free-artp/talker_hardware/README.md

Eagle project about ATMEGA168 for wood's sort device (p-dok.ru)

Print out:
	Bottom
	Pad
	Via
	Dimension
	Holes

Mirror + Pos.coord

Offcet:
X = 2.2 inch
Y = 7 inch

Hot iron - 40 sec, full power, by my hand not a body
11:38
