free-artp/talker_hardware/sortirovka/README.txt

top_metal.gbr		- Медь, верхний слой.
top_metal.gpi		- Информация о формате файла верхнего слоя меди
bottom_metal.gbr	- Медь, нижний слой.
bottom_metal.gpi	- Информация о формате файла нижнего слоя меди.
top_mask.gbr		- Паяльная маска (Solder Stop), верхний слой.
top_mask.gpi		- Инфо о формате файла паяльной маски верхнего слоя.
bottom_mask.gbr		- Паяльная маска (Solder stop), нижнй слой.
bottom_mask.gpi		- Инфо о формате файла паяльной маски нижнего слоя
brd.gbr			- Слой габаритных размеров платы
brd.gpi			- Информация о формате файла габаритных размеров
drill.dri		- Файл сверловки, формат EXCELON
drill.txt		- Информация о формате файла сверловки
top_silk.gbr		- Шелкография, верхний слой.
top_silk.gpi		- Информация о формате файла шелкографии.
