free-artp/talker_hardware/pcb.png

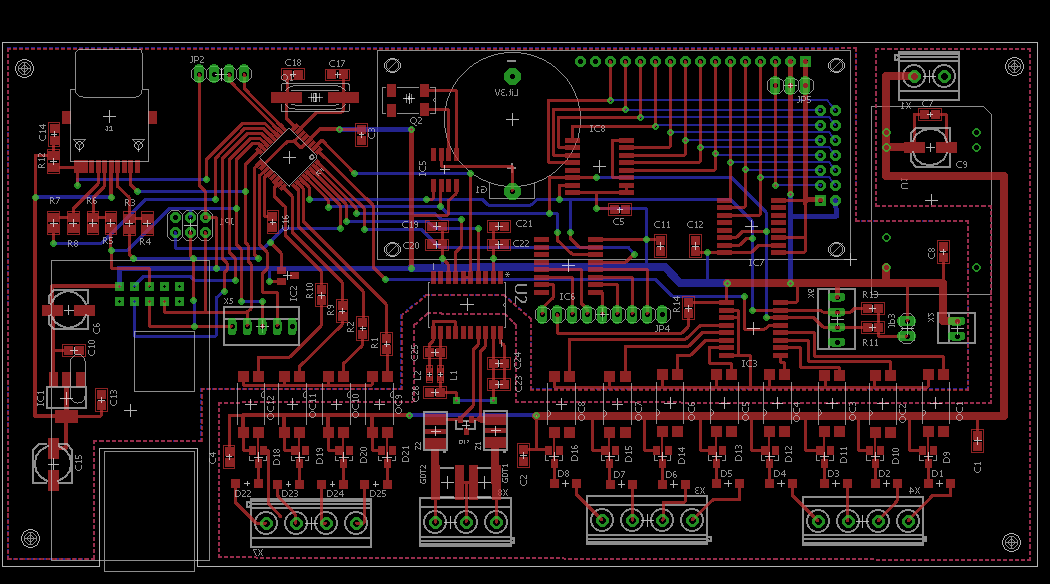
pcb.png
