free-artp/talker_hardware/sortirovka.brd

## EAGLE design sortirovka.brd (2017-11-27)

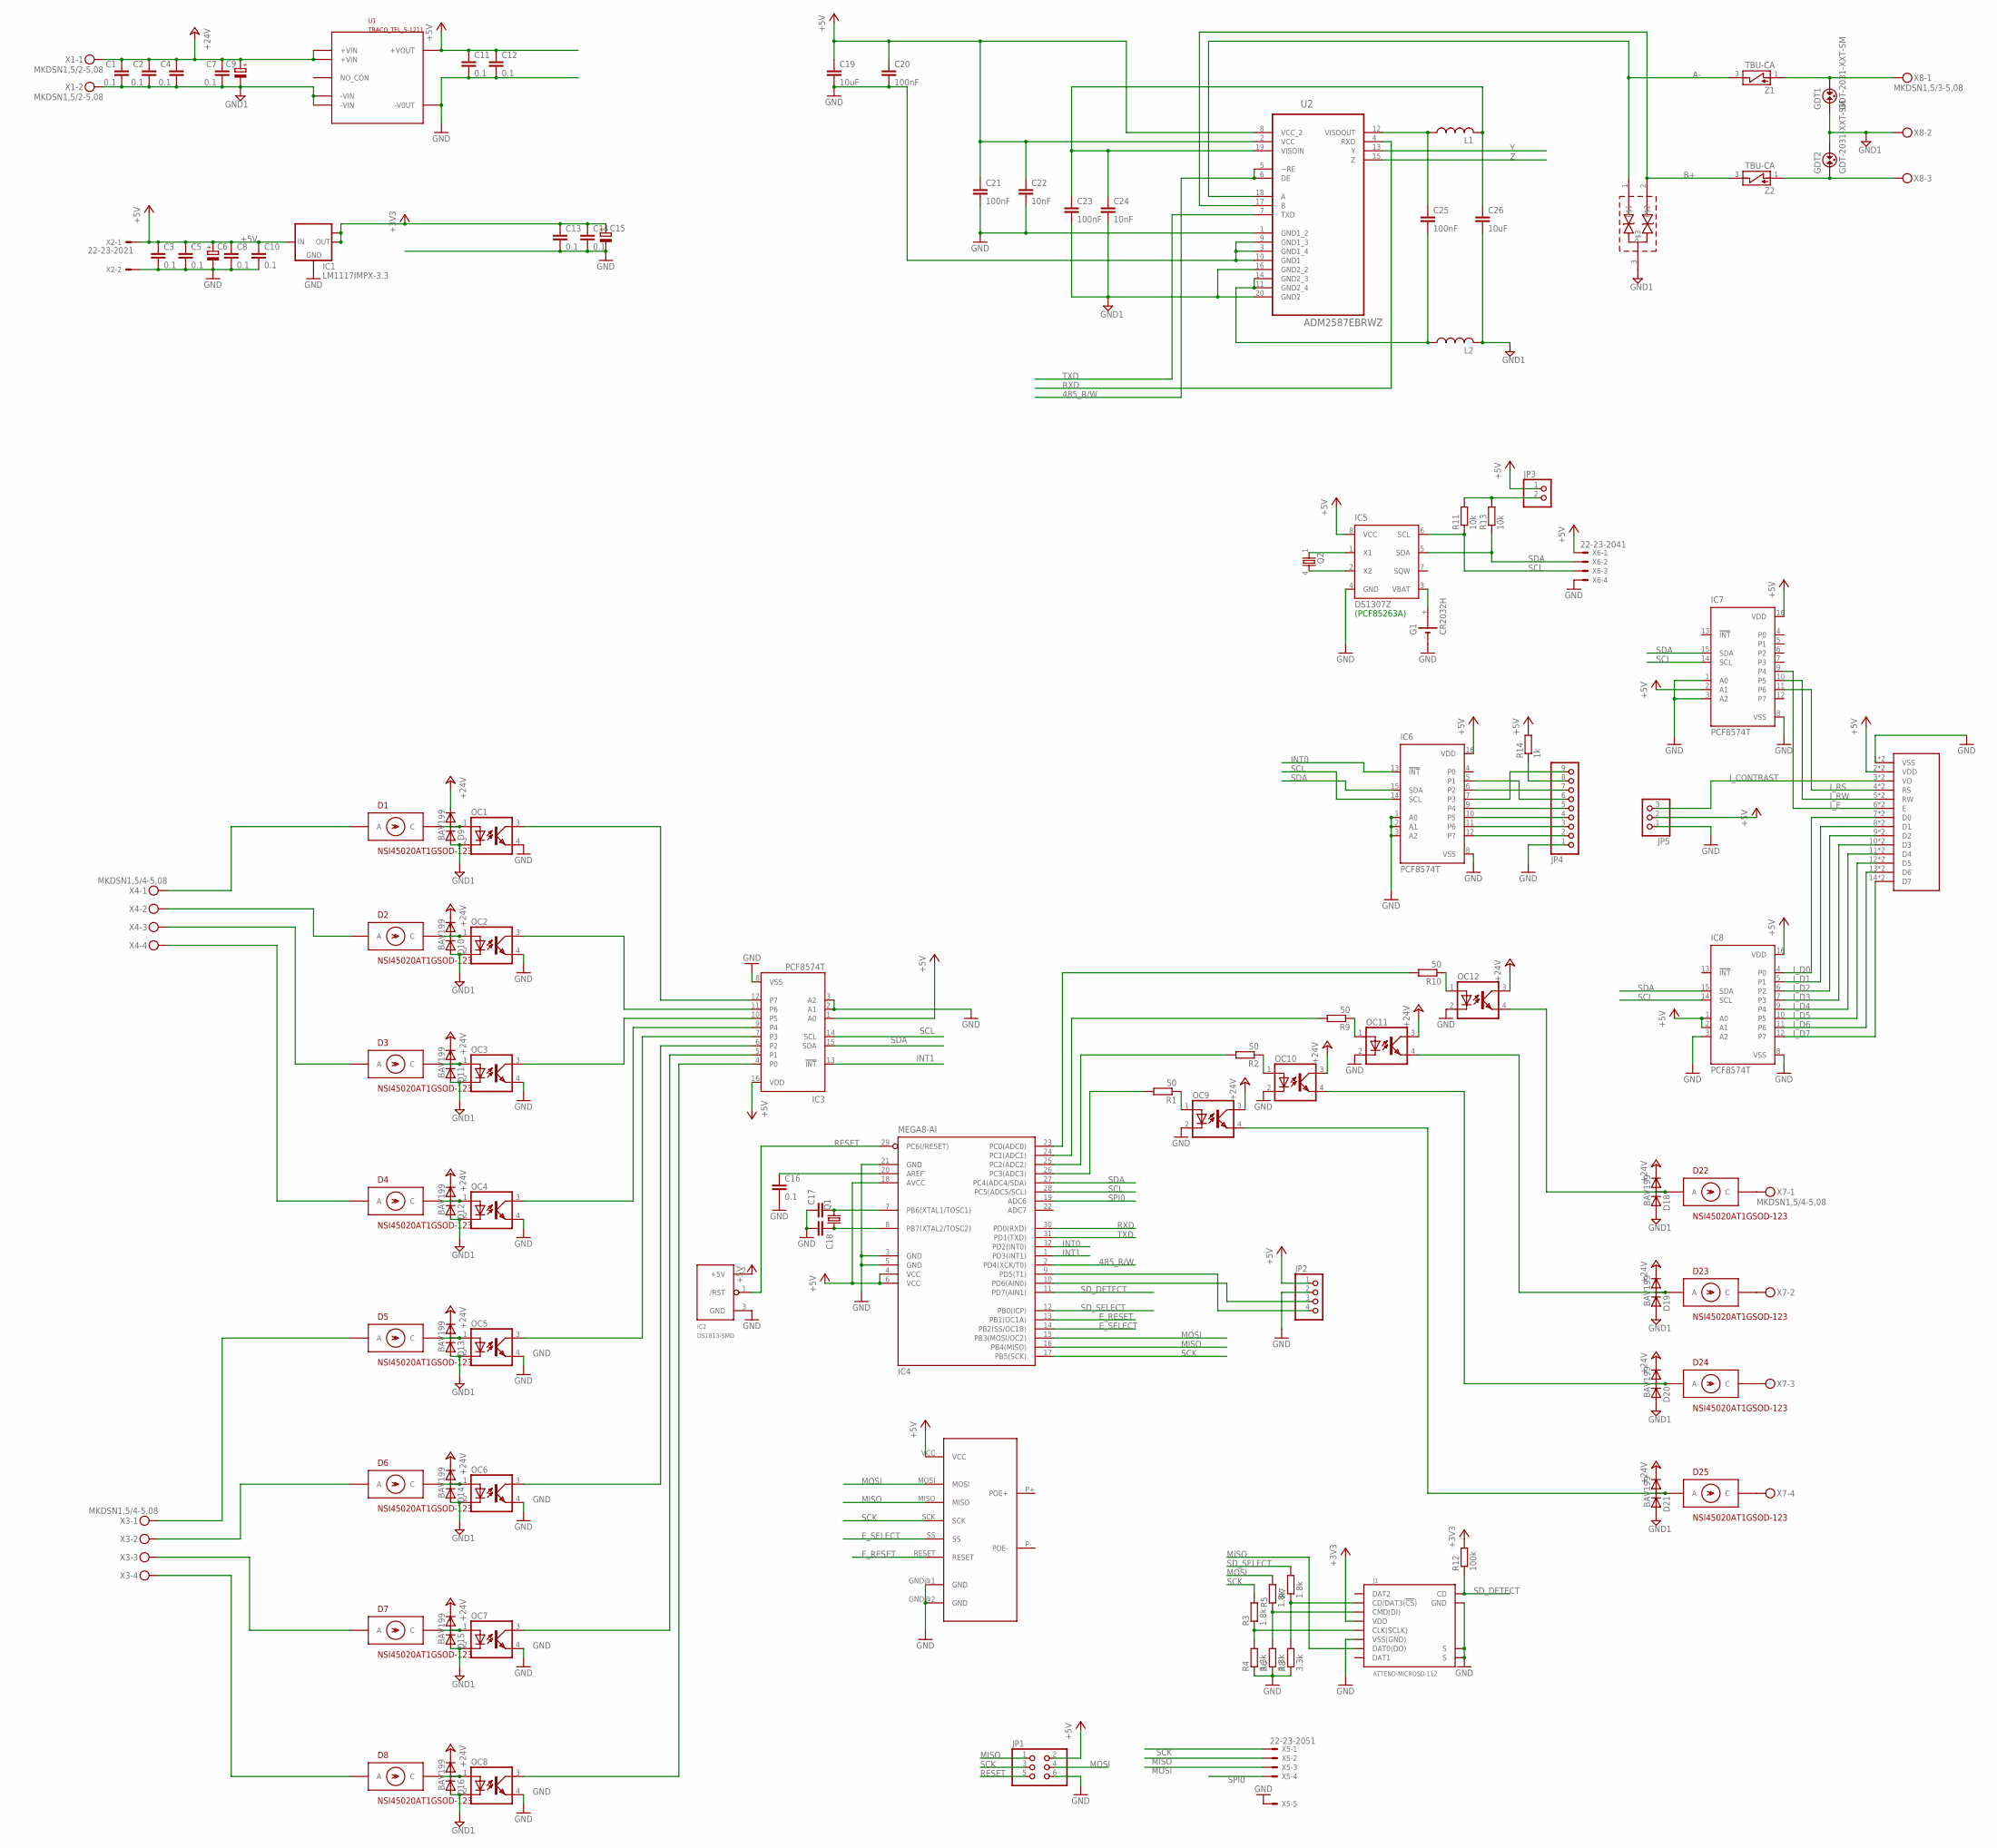
[picture p2: schematic sortirovka.sch]

Parts:
C1, C2, C3, C4, C5, C7, C8, C10, C11, C12, C13, C14, C16: 0.1; C0805
C6, C9, C15: CPOL-EU153CLV-0605; 153CLV-0605
C17, C18: C-EUC0805; C0805
C19, C26: 10uF; C0805
C20, C21, C23, C25: 100nF; C0805
C22, C24: 10nF; C0805
D1, D2, D3, D4, D5, D6, D7, D8, D22, D23, D24, D25: NSI45020AT1GSOD-123; SOD123
D9, D10, D11, D12, D13, D14, D15, D16, D18, D19, D20, D21: BAV199; SOT23
D17: CDSOT23-SM712SOT23-R; SOT23-R
G1: CR2032H
GDT1, GDT2: GDT-2031-XXT-SM; 2031-XXT-SM
IC1: LM1117IMPX-3.3; SOT223
IC2: DS1813-SMD; SOT-23
IC3, IC6, IC7, IC8: PCF8574T; SO16W
IC4: MEGA8-AI; TQFP32-08
IC5: DS1307Z; SOIC8
J1: ATTEND-MICROSD-112; ATTEND-112
JP1: PINHD-2X3; 2X03
JP2: PINHD-1X4; 1X04
JP3: PINHD-1X2; 1X02
JP4: PINHD-1X9; 1X09
JP5: PINHD-1X3; 1X03
L1, L2: L-US0402; L0402
LCD1: 2X16LCDBOTHM162SD07; 2X16LCDBOTH-1
MOD1: W5100_MODULESMALL; W5100_MODULE_1
OC1, OC2, OC3, OC4, OC5, OC6, OC7, OC8, OC9, OC10, OC11, OC12: SFH6106REAL; SFH6106
Q1: CRYSTALSM49; SM49
Q2: MA306
R1, R2, R9, R10: 50; R0805
R3, R5, R7: 1.8k; M0805
R4, R6, R8: 3.3k; M0805
R11, R13: 10k; R0805
R12: 100k; M0805
R14: 1k; R0805
U1: TRACO_TEL_5-1211; TRACO_POWER_TL5
U2: ADM2587EBRWZ; SOIC127P1032X265-20N
X1: MKDSN1,5/2-5,08
X2: 22-23-2021
X3, X4, X7: MKDSN1,5/4-5,08
X5: 22-23-2051
X6: 22-23-2041
X8: MKDSN1,5/3-5,08
Z1, Z2: TBU-CA

Connections:
485_R/W: IC4.2 (PD4(XCK/T0)), U2.5 (~RE), U2.6 (DE)
+3V3: C13.1, C14.1, C15.+, IC1.2 (OUT), IC1.TAB (OUT1), J1.VDD, R12.2
+5V: C3.1, C5.1, C6.+, C8.1, C10.1, C11.1, C12.1, C19.1, C20.1, C21.1, C22.1, IC1.3 (IN), IC2.2 (+5V), IC3.1 (A0), IC3.16 (VDD), IC4.4 (VCC), IC4.6 (VCC), IC4.18 (AVCC), IC5.8 (VCC), IC6.16 (VDD), IC7.2 (A1), IC7.16 (VDD), IC8.1 (A0), IC8.2 (A1), IC8.16 (VDD), JP1.2, JP2.1, JP3.1, JP5.2, LCD1.2 (VDD), LCD1.16 (VDD), MOD1.VCC, R14.2, U1.+VOUT, U2.2 (VCC), U2.8 (VCC_2), X2.1, X6.1
+24V: C1.1, C2.1, C4.1, C7.1, C9.+, D9.2 (C), D10.2 (C), D11.2 (C), D12.2 (C), D13.2 (C), D14.2 (C), D15.2 (C), D16.2 (C), D18.2 (C), D19.2 (C), D20.2 (C), D21.2 (C), OC9.3 (COL), OC10.3 (COL), OC11.3 (COL), OC12.3 (COL), U1.+VIN@1 (+VIN), U1.+VIN@2 (+VIN), X1.1
A-: D17.1, U2.18 (A), Z1.3 (2)
B+: D17.2, U2.17 (B), Z2.3 (2)
E_RESET: IC4.13 (PB1(OC1A)), MOD1.RESET
E_SELECT: IC4.14 (PB2(SS/OC1B)), MOD1.SS
GND: C3.2, C5.2, C6.-, C8.2, C10.2, C11.2, C12.2, C13.2, C14.2, C15.-, C16.2, C17.1, C18.2, C19.2, C20.2, C21.2, C22.2, G1.-, IC1.1 (GND), IC2.3 (GND), IC3.2 (A1), IC3.3 (A2), IC3.8 (VSS), IC4.3 (GND), IC4.5 (GND), IC4.21 (GND), IC5.4 (GND), IC6.1 (A0), IC6.2 (A1), IC6.3 (A2), IC6.8 (VSS), IC7.1 (A0), IC7.3 (A2), IC7.8 (VSS), IC8.3 (A2), IC8.8 (VSS), J1.GND, J1.S1 (S), J1.S2 (S), J1.VSS (VSS(GND)), JP1.6, JP2.2, JP4.1, JP5.1, LCD1.1 (VSS), LCD1.15 (VSS), MOD1.GND@1 (GND), MOD1.GND@2 (GND), OC1.4 (EMIT), OC2.4 (EMIT), OC3.4 (EMIT), OC4.4 (EMIT), OC5.4 (EMIT), OC6.4 (EMIT), OC7.4 (EMIT), OC8.4 (EMIT), OC9.2 (C), OC10.2 (C), OC11.2 (C), OC12.2 (C), R4.1, R6.1, R8.1, U1.-VOUT (-V0UT), U2.1 (GND1_2), U2.3 (GND1_4), U2.9 (GND1_3), U2.10 (GND1), X2.2, X5.5, X6.4
GND1: C1.2, C2.2, C4.2, C7.2, C9.-, C23.2, C24.2, C26.2, D9.1 (A), D10.1 (A), D11.1 (A), D12.1 (A), D13.1 (A), D14.1 (A), D15.1 (A), D16.1 (A), D17.3, D18.1 (A), D19.1 (A), D20.1 (A), D21.1 (A), GDT1.1, GDT2.2, L2.2, OC1.2 (C), OC2.2 (C), OC3.2 (C), OC4.2 (C), OC5.2 (C), OC6.2 (C), OC7.2 (C), OC8.2 (C), U1.-VIN@1 (-VIN), U1.-VIN@2 (-VIN), U2.16 (GND2_2), U2.20 (GND2), X1.2, X8.2
INT0: IC4.32 (PD2(INT0)), IC6.13 (!INT)
INT1: IC3.13 (!INT), IC4.1 (PD3(INT1))
I_CONTRAST: JP5.3, LCD1.3 (VO), LCD1.17 (VO)
I_D0: IC8.4 (P0), LCD1.7 (D0), LCD1.21 (D0)
I_D1: IC8.5 (P1), LCD1.8 (D1), LCD1.22 (D1)
I_D2: IC8.6 (P2), LCD1.9 (D2), LCD1.23 (D2)
I_D3: IC8.7 (P3), LCD1.10 (D3), LCD1.24 (D3)
I_D4: IC8.9 (P4), LCD1.11 (D4), LCD1.25 (D4)
I_D5: IC8.10 (P5), LCD1.12 (D5), LCD1.26 (D5)
I_D6: IC8.11 (P6), LCD1.13 (D6), LCD1.27 (D6)
I_D7: IC8.12 (P7), LCD1.14 (D7), LCD1.28 (D7)
I_E: IC7.9 (P4), LCD1.6 (E), LCD1.20 (E)
I_RS: IC7.11 (P6), LCD1.4 (RS), LCD1.18 (RS)
I_RW: IC7.10 (P5), LCD1.5 (RW), LCD1.19 (RW)
MISO: IC4.16 (PB4(MISO)), J1.DAT0 (DAT0(DO)), JP1.1, MOD1.MISO, X5.2
MOSI: IC4.15 (PB3(MOSI/OC2)), JP1.4, MOD1.MOSI, R5.2, X5.3
unnamed: GDT1.2, X8.1, Z1.1
unnamed: GDT2.1, X8.3, Z2.1
unnamed: C23.1, C24.1, C26.1, L1.2, U2.19 (VISOIN)
unnamed: C25.2, L2.1, U2.11 (GND2_4), U2.14 (GND2_3)
unnamed: C25.1, L1.1, U2.12 (VISOOUT)
unnamed: IC4.23 (PC0(ADC0)), R10.2
unnamed: IC4.24 (PC1(ADC1)), R9.2
unnamed: IC4.25 (PC2(ADC2)), R2.2
unnamed: IC4.26 (PC3(ADC3)), R1.2
unnamed: D18.3 (AC), D22.A, OC12.4 (EMIT)
unnamed: D19.3 (AC), D23.A, OC11.4 (EMIT)
unnamed: D20.3 (AC), D24.A, OC10.4 (EMIT)
unnamed: D21.3 (AC), D25.A, OC9.4 (EMIT)
unnamed: C18.1, IC4.8 (PB7(XTAL2/TOSC2)), Q1.1
unnamed: OC9.1 (A), R1.1
unnamed: D1.C, D9.3 (AC), OC1.1 (A)
unnamed: D2.C, D10.3 (AC), OC2.1 (A)
unnamed: OC10.1 (A), R2.1
unnamed: OC11.1 (A), R9.1
unnamed: G1.+, IC5.3 (VBAT)
unnamed: D1.A, X4.1
unnamed: D2.A, X4.2
unnamed: IC5.1 (X1), Q2.1
unnamed: D3.C, D11.3 (AC), OC3.1 (A)
unnamed: IC5.2 (X2), Q2.4 (2)
unnamed: C17.2, IC4.7 (PB6(XTAL1/TOSC1)), Q1.2
unnamed: D4.C, D12.3 (AC), OC4.1 (A)
unnamed: D7.A, X3.3
unnamed: OC12.1 (A), R10.1
unnamed: D5.C, D13.3 (AC), OC5.1 (A)
unnamed: D6.C, D14.3 (AC), OC6.1 (A)
unnamed: D4.A, X4.4
unnamed: D7.C, D15.3 (AC), OC7.1 (A)
unnamed: D3.A, X4.3
unnamed: D8.C, D16.3 (AC), OC8.1 (A)
unnamed: D5.A, X3.1
unnamed: D6.A, X3.2
unnamed: D8.A, X3.4
unnamed: IC3.6 (P2), OC6.3 (COL)
unnamed: IC3.5 (P1), OC7.3 (COL)
unnamed: IC3.4 (P0), OC8.3 (COL)
unnamed: J1.DAT3 (CD/DAT3(!CS!)), R7.1, R8.2
unnamed: IC6.12 (P7), JP4.2
unnamed: IC6.11 (P6), JP4.3
unnamed: IC6.10 (P5), JP4.4
unnamed: IC6.5 (P1), JP4.6
unnamed: IC6.9 (P4), JP4.5
unnamed: IC6.7 (P3), JP4.9
unnamed: IC6.6 (P2), JP4.7
unnamed: JP4.8, R14.1
unnamed: IC3.12 (P7), OC1.3 (COL)
unnamed: IC3.11 (P6), OC2.3 (COL)
unnamed: IC3.10 (P5), OC3.3 (COL)
unnamed: IC3.9 (P4), OC4.3 (COL)
unnamed: IC3.7 (P3), OC5.3 (COL)
unnamed: J1.CMD (CMD(DI)), R5.1, R6.2
unnamed: J1.CLK (CLK(SCLK)), R3.1, R4.2
unnamed: C16.1, IC4.20 (AREF)
unnamed: D22.C, X7.1
unnamed: D23.C, X7.2
unnamed: IC4.10 (PD6(AIN0)), JP2.3
unnamed: D24.C, X7.3
unnamed: IC4.9 (PD5(T1)), JP2.4
unnamed: D25.C, X7.4
unnamed: JP3.2, R11.2, R13.2
RESET: IC2.1 (/RST), IC4.29 (PC6(/RESET)), JP1.5
RXD: IC4.30 (PD0(RXD)), U2.4 (RXD)
SCK: IC4.17 (PB5(SCK)), JP1.3, MOD1.SCK, R3.2, X5.1
SCL: IC3.14 (SCL), IC4.28 (PC5(ADC5/SCL)), IC5.6 (SCL), IC6.14 (SCL), IC7.14 (SCL), IC8.14 (SCL), R11.1, X6.3
SDA: IC3.15 (SDA), IC4.27 (PC4(ADC4/SDA)), IC5.5 (SDA), IC6.15 (SDA), IC7.15 (SDA), IC8.15 (SDA), R13.1, X6.2
SD_DETECT: IC4.11 (PD7(AIN1)), J1.CD, R12.1
SD_SELECT: IC4.12 (PB0(ICP)), R7.2
SPI0: IC4.19 (ADC6), X5.4
TXD: IC4.31 (PD1(TXD)), U2.7 (TXD)
Y: U2.13 (Y)
Z: U2.15 (Z)

Notes on the sheet:
(PCF85263A)

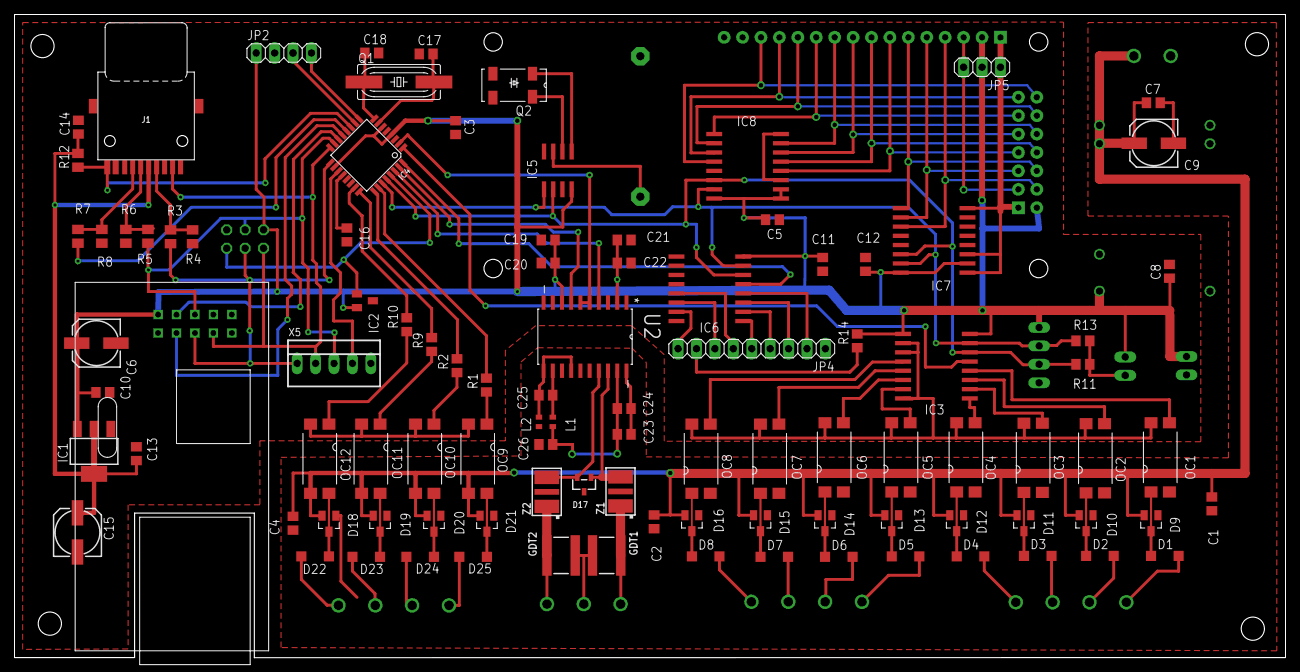
[picture p3: board sortirovka.brd from above]

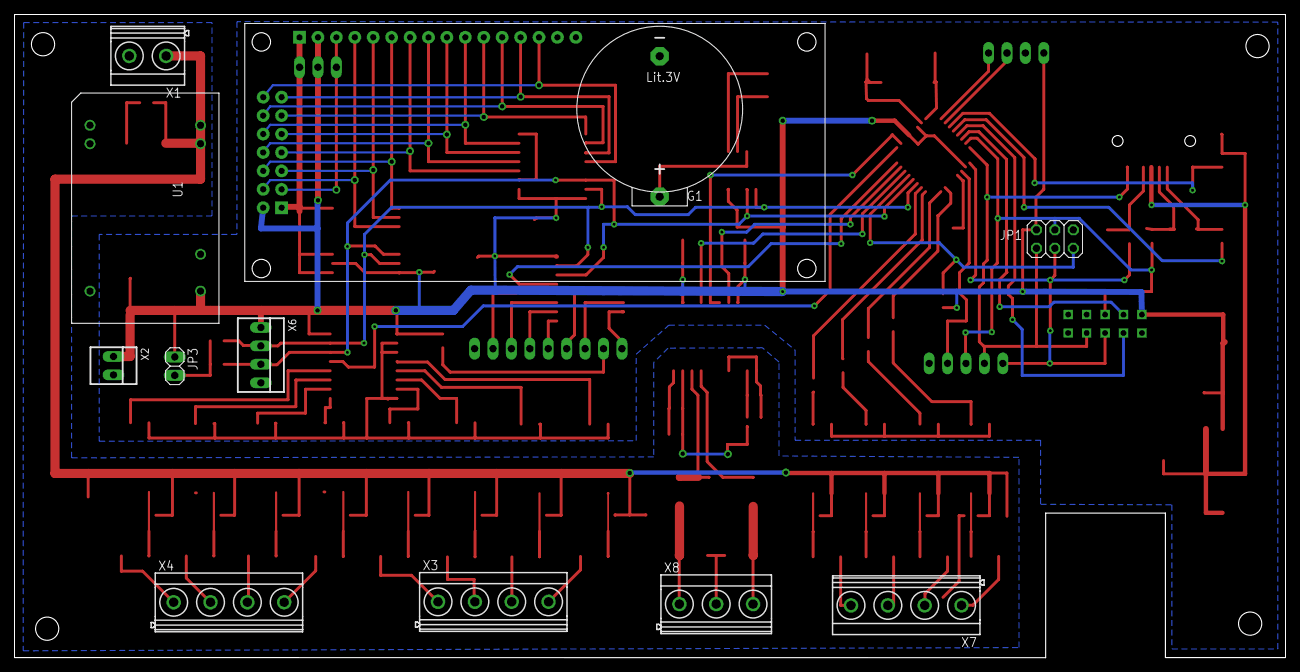
[picture p4: board sortirovka.brd from below]

Board: 2 copper layers, 175.2 x 88.7 mm, 112 parts (12 on the bottom side), 100 nets.
