free-artp/talker_hardware/TODO.txt

1. заменить L1,L2 - BLM15HD182SN1 (0402) на что-то более паяемое BLM18HD... (0805)
2. вывести на SPI +5 и +3.3 V
3. выходные оптроны повесить на PCF8574 и сделать их 8
4. сделать независимыми внешние земли отпронов (хотя бы группами)
5. развести W5500
6. соединить A-Z и B-Y
7. терминирующий резистор с джампером в линию.
8. развязать DE и ~RE

28/11/2017
1. запаял  A-Z и B-Y. заменил индуктивности ADM2587 на перемычки . Заработало
2. 120 в линию надо вешать на сканере. Тем не менее, сделать ее на контроллере, с джампером.
3. на сканере правый нижний разъем: пит-; х; х;х ;485+ ; земля; 485-; пит+
4. на плате 485+ от сканера заводить на левый болтик (со стороны монтажа, разъемом ко мне)
