free-artp/talker_hardware/(commit log)

2017-06-19 rev2 5-input 4-output
    [sortirovka.brd, sortirovka.sch]
2017-06-22 rev1.0 to produce
    [sortirovka.brd, sortirovka.sch]
2017-06-24 some changes in packages
    [sortirovka.brd, sortirovka.sch]
2017-07-05 rev 1.1 to produce
    [sortirovka.brd, sortirovka.sch]
2017-09-27 main pars on the board
    [sortirovka.brd, sortirovka.sch]
2017-10-10 All routed.
    [sortirovka.brd, sortirovka.sch]
2017-10-11 Ready to gerber
    [sortirovka.brd, sortirovka.sch]
2017-10-18 Prepared to rezonver
    [sortirovka.brd, sortirovka.sch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]
