free-artp/talker_hardware/(notices)

Notices in the files:
parts and their libraries:
supressor: Copyright (C) 2009, Bob Starr
